grantbreaksthings/buggyboy/docs/dtmf_r.png

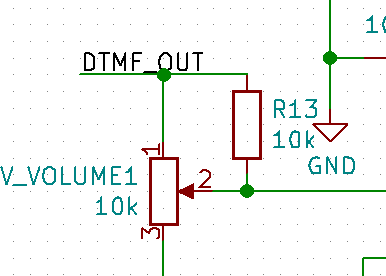
docs/dtmf_r.png
