grantbreaksthings/buggyboy/docs/mic_r.png

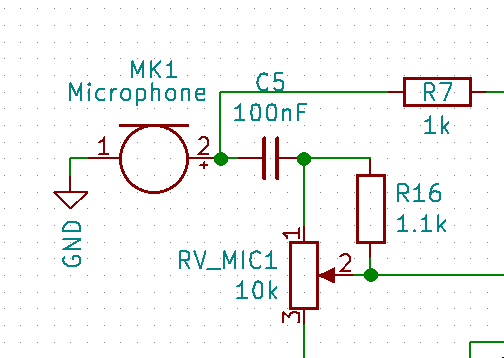
docs/mic_r.png
