grantbreaksthings/buggyboy/hardware/buggyboy/brains.kicad_pcb

## KiCad design hardware/buggyboy/brains.kicad_pcb (2022-06-12)

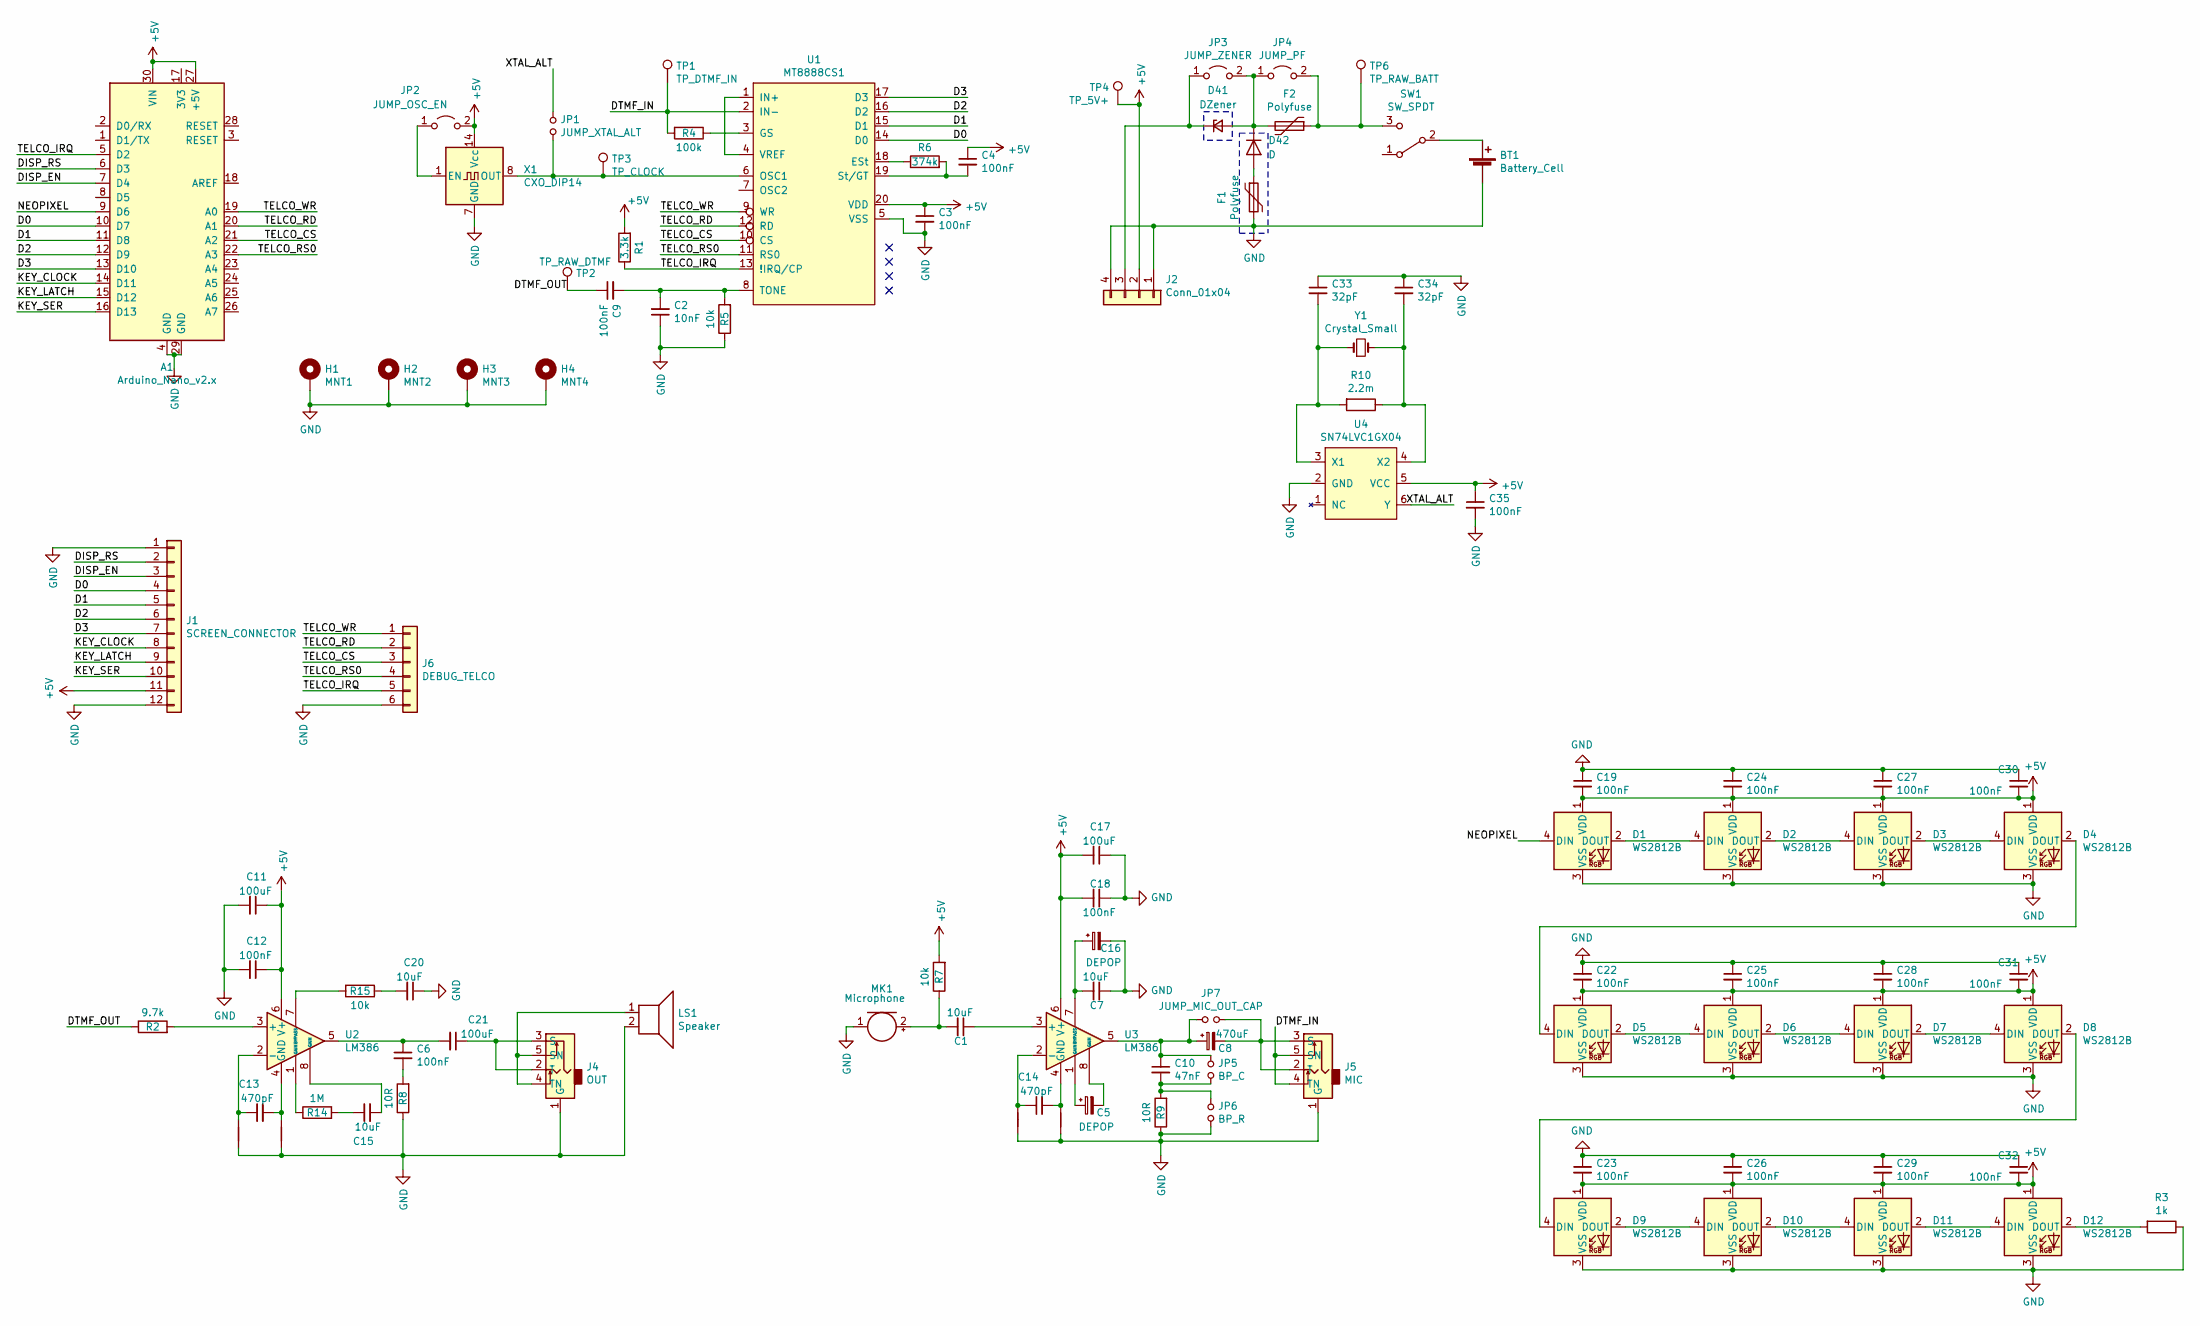
[picture p3: schematic brains.sch]

Parts:
A1: Arduino_Nano_v2.x; Arduino_Nano
BT1: Battery_Cell; BatteryHolder_BC2AAPC
C1, C7, C15, C20: 10uF; C_0805_2012Metric_Pad1.18x1.45mm_HandSolder
C2: 10nF; C_0805_2012Metric_Pad1.18x1.45mm_HandSolder
C3, C4, C6, C9, C12, C18, C19, C22, C23, C24, C25, C26, C27, C28, C29, C30, C31, C32, C35: 100nF; C_0603_1608Metric_Pad1.08x0.95mm_HandSolder
C5, C16: DEPOP; CP_Radial_D8.0mm_P3.80mm
C8: 470uF; CP_Radial_D8.0mm_P3.80mm
C10: 47nF; C_0603_1608Metric_Pad1.08x0.95mm_HandSolder
C11, C17, C21: 100uF; C_1206_3216Metric_Pad1.33x1.80mm_HandSolder
C13, C14: 470pF; C_0805_2012Metric_Pad1.18x1.45mm_HandSolder
C33, C34: 32pF; C_0402_1005Metric_Pad0.74x0.62mm_HandSolder
D1, D2, D3, D4, D5, D6, D7, D8, D9, D10, D11, D12: WS2812B; LED_WS2812B_PLCC4_5.0x5.0mm_P3.2mm
D41: DZener; D_SMB_Handsoldering
D42: D; D_SMA_Handsoldering
F1, F2: Polyfuse; Fuse_Littelfuse_395Series
H1: MNT1; MountingHole_4.3mm_M4_Pad_Via
H2: MNT2; MountingHole_4.3mm_M4_Pad_Via
H3: MNT3; MountingHole_4.3mm_M4_Pad_Via
H4: MNT4; MountingHole_4.3mm_M4_Pad_Via
J1: SCREEN_CONNECTOR; PinHeader_1x12_P2.54mm_Vertical
J2: Conn_01x04; MT3608_MODULE
J4: OUT; CUI_SJ1-3545N
J5: MIC; CUI_SJ1-3545N
J6: DEBUG_TELCO; PinHeader_1x06_P2.54mm_Vertical
JP1: JUMP_XTAL_ALT; SolderJumper-2_P1.3mm_Open_RoundedPad1.0x1.5mm
JP2: JUMP_OSC_EN; SolderJumper-2_P1.3mm_Open_RoundedPad1.0x1.5mm
JP3: JUMP_ZENER; SolderJumper-2_P1.3mm_Open_RoundedPad1.0x1.5mm
JP4: JUMP_PF; SolderJumper-2_P1.3mm_Open_RoundedPad1.0x1.5mm
JP5: BP_C; SolderJumper-2_P1.3mm_Open_RoundedPad1.0x1.5mm
JP6: BP_R; SolderJumper-2_P1.3mm_Open_RoundedPad1.0x1.5mm
JP7: JUMP_MIC_OUT_CAP; SolderJumper-2_P1.3mm_Open_RoundedPad1.0x1.5mm
LS1: Speaker; PinSocket_1x02_P2.54mm_Vertical
MK1: Microphone; PinSocket_1x02_P2.54mm_Vertical
NT1, NT2, NT3, NT4: Net-Tie_2; NetTie-2_SMD_Pad0.5mm
R1: 3.3k; R_0805_2012Metric_Pad1.20x1.40mm_HandSolder
R2: 9.7k; R_0805_2012Metric_Pad1.20x1.40mm_HandSolder
R3: 1k; R_0805_2012Metric_Pad1.20x1.40mm_HandSolder
R4: 100k; R_0805_2012Metric_Pad1.20x1.40mm_HandSolder
R5, R7, R15: 10k; R_0805_2012Metric_Pad1.20x1.40mm_HandSolder
R6: 374k; R_0805_2012Metric_Pad1.20x1.40mm_HandSolder
R8, R9: 10R; R_0805_2012Metric_Pad1.20x1.40mm_HandSolder
R10: 2.2m; R_0805_2012Metric_Pad1.20x1.40mm_HandSolder
R14: 1M; R_0805_2012Metric_Pad1.20x1.40mm_HandSolder
SW1: SW_SPDT; SW_E-Switch_EG1224_SPDT_Angled
TP1: TP_DTMF_IN; TestPoint_Pad_D2.5mm
TP2: TP_RAW_DTMF; TestPoint_Pad_D2.5mm
TP3: TP_CLOCK; TestPoint_Pad_D2.5mm
TP4: TP_5V+; TestPoint_Pad_D2.5mm
TP6: TP_RAW_BATT; TestPoint_Pad_D2.5mm
U1: MT8888CS1; SOIC-20W_7.5x12.8mm_P1.27mm
U2, U3: LM386; DIP-8_W7.62mm_LongPads
U4: SN74LVC1GX04; SOT-563
X1: CXO_DIP14; Oscillator_DIP-14
Y1: Crystal_Small; Crystal_HC49-U_Vertical

Connections:
+5V: A1.27 (+5V), A1.30 (VIN), C3.1, C4.1, C11.1, C12.1, C17.2, C18.2, C19.2, C22.2, C23.2, C24.2, C25.2, C26.2, C27.2, C28.2, C29.2, C30.2, C31.2, C32.2, C35.1, D1.1 (VDD), D2.1 (VDD), D3.1 (VDD), D4.1 (VDD), D5.1 (VDD), D6.1 (VDD), D7.1 (VDD), D8.1 (VDD), D9.1 (VDD), D10.1 (VDD), D11.1 (VDD), D12.1 (VDD), J1.11, J2.2, JP2.2 (B), R1.2, R7.2, TP4.1, U1.20 (VDD), U2.6 (V+), U3.6 (V+), U4.5 (VCC), X1.14 (Vcc)
/D0: A1.10 (D7), J1.4, U1.14 (D0)
/D1: A1.11 (D8), J1.5, U1.15 (D1)
/D2: A1.12 (D9), J1.6, U1.16 (D2)
/D3: A1.13 (D10), J1.7, U1.17 (D3)
/DISP_EN: A1.7 (D4), J1.3
/DISP_RS: A1.6 (D3), J1.2
/DTMF_IN: J5.4 (TN), J5.5 (SN), R4.2, TP1.1, U1.2 (IN-)
/DTMF_OUT: C9.1, R2.1, TP2.1
/KEY_CLOCK: A1.14 (D11), J1.8
/KEY_LATCH: A1.15 (D12), J1.9
/KEY_SER: A1.16 (D13), J1.10
/NEOPIXEL: A1.9 (D6), D1.4 (DIN)
/TELCO_CS: A1.21 (A2), J6.3, U1.10 (CS)
/TELCO_IRQ: A1.5 (D2), J6.5, R1.1, U1.13 (!IRQ/CP)
/TELCO_RD: A1.20 (A1), J6.2, U1.12 (RD)
/TELCO_RS0: A1.22 (A3), J6.4, U1.11 (RS0)
/TELCO_WR: A1.19 (A0), J6.1, U1.9 (WR)
/XTAL_ALT: JP1.1, U4.6 (Y)
GND: A1.4 (GND), A1.29 (GND), BT1.2 (-), C2.1, C3.2, C7.1, C11.2, C12.2, C16.2, C17.1, C18.1, C19.1, C20.1, C22.1, C23.1, C24.1, C25.1, C26.1, C27.1, C28.1, C29.1, C30.1, C31.1, C32.1, C33.1, C34.1, C35.2, D1.3 (VSS), D2.3 (VSS), D3.3 (VSS), D4.3 (VSS), D5.3 (VSS), D6.3 (VSS), D7.3 (VSS), D8.3 (VSS), D9.3 (VSS), D10.3 (VSS), D11.3 (VSS), D12.3 (VSS), F1.2, H1.1, H2.1, H3.1, H4.1, J1.1, J1.12, J2.1, J2.4, J4.1 (G), J5.1 (G), J6.6, JP6.2, LS1.2, MK1.1 (-), NT1.2, NT2.2, NT3.2, NT4.2, R3.1, R5.1, R8.1, R9.1, U1.5 (VSS), U4.2 (GND), X1.7 (GND)
unnamed: BT1.1 (+), SW1.2 (B)
unnamed: C1.1, U3.3 (+)
unnamed: C1.2, MK1.2 (+), R7.1
unnamed: C2.2, C9.2, R5.2, U1.8 (TONE)
unnamed: C4.2, R6.2, U1.19 (St/GT)
unnamed: C5.1, U3.1 (GAIN)
unnamed: C5.2, U3.8 (GAIN)
unnamed: C6.2, R8.2
unnamed: C8.2, J5.2 (T), J5.3 (S), JP7.2
unnamed: C8.1, C10.1, JP5.1, JP7.1, U3.5
unnamed: C10.2, JP5.2, JP6.1, R9.2
unnamed: C13.1, NT1.1, U2.2 (-)
unnamed: C13.2, NT2.1, U2.4 (GND)
unnamed: C14.1, NT3.1, U3.2 (-)
unnamed: C14.2, NT4.1, U3.4 (GND)
unnamed: C15.1, R14.2
unnamed: C15.2, U2.8 (GAIN)
unnamed: C7.2, C16.1, U3.7 (BYPASS)
unnamed: C20.2, R15.1
unnamed: C21.1, J4.2 (T), J4.3 (S)
unnamed: C6.1, C21.2, U2.5
unnamed: C33.2, R10.2, U4.3 (X1), Y1.1
unnamed: C34.2, R10.1, U4.4 (X2), Y1.2
unnamed: D1.2 (DOUT), D2.4 (DIN)
unnamed: D2.2 (DOUT), D3.4 (DIN)
unnamed: D3.2 (DOUT), D4.4 (DIN)
unnamed: D4.2 (DOUT), D5.4 (DIN)
unnamed: D5.2 (DOUT), D6.4 (DIN)
unnamed: D6.2 (DOUT), D7.4 (DIN)
unnamed: D7.2 (DOUT), D8.4 (DIN)
unnamed: D8.2 (DOUT), D9.4 (DIN)
unnamed: D10.2 (DOUT), D11.4 (DIN)
unnamed: D9.2 (DOUT), D10.4 (DIN)
unnamed: D11.2 (DOUT), D12.4 (DIN)
unnamed: D12.2 (DOUT), R3.2
unnamed: D41.1 (K), J2.3, JP3.1 (A)
unnamed: D41.2 (A), D42.1 (K), F2.2, JP3.2 (B), JP4.1 (A)
unnamed: D42.2 (A), F1.1
unnamed: F2.1, JP4.2 (B), SW1.3 (C), TP6.1
unnamed: J4.4 (TN), J4.5 (SN), LS1.1
unnamed: JP1.2, TP3.1, U1.6 (OSC1), X1.8 (OUT)
unnamed: JP2.1 (A), X1.1 (EN)
unnamed: R2.2, U2.3 (+)
unnamed: R4.1, U1.3 (GS)
unnamed: R6.1, U1.18 (ESt)
unnamed: R14.1, U2.1 (GAIN)
unnamed: R15.2, U2.7 (BYPASS)
unnamed: U1.1 (IN+), U1.4 (VREF)

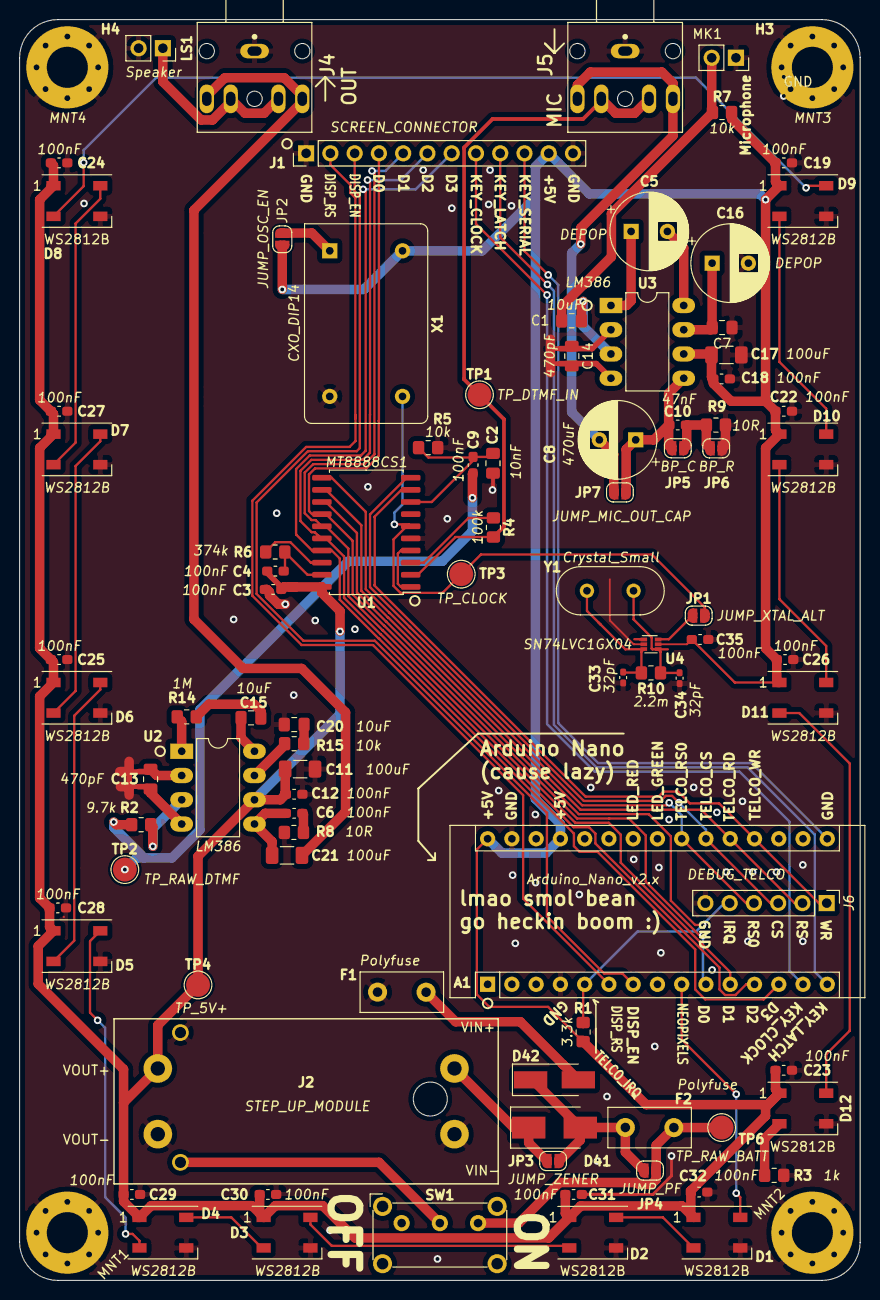
[picture p4: board brains.kicad_pcb from above]

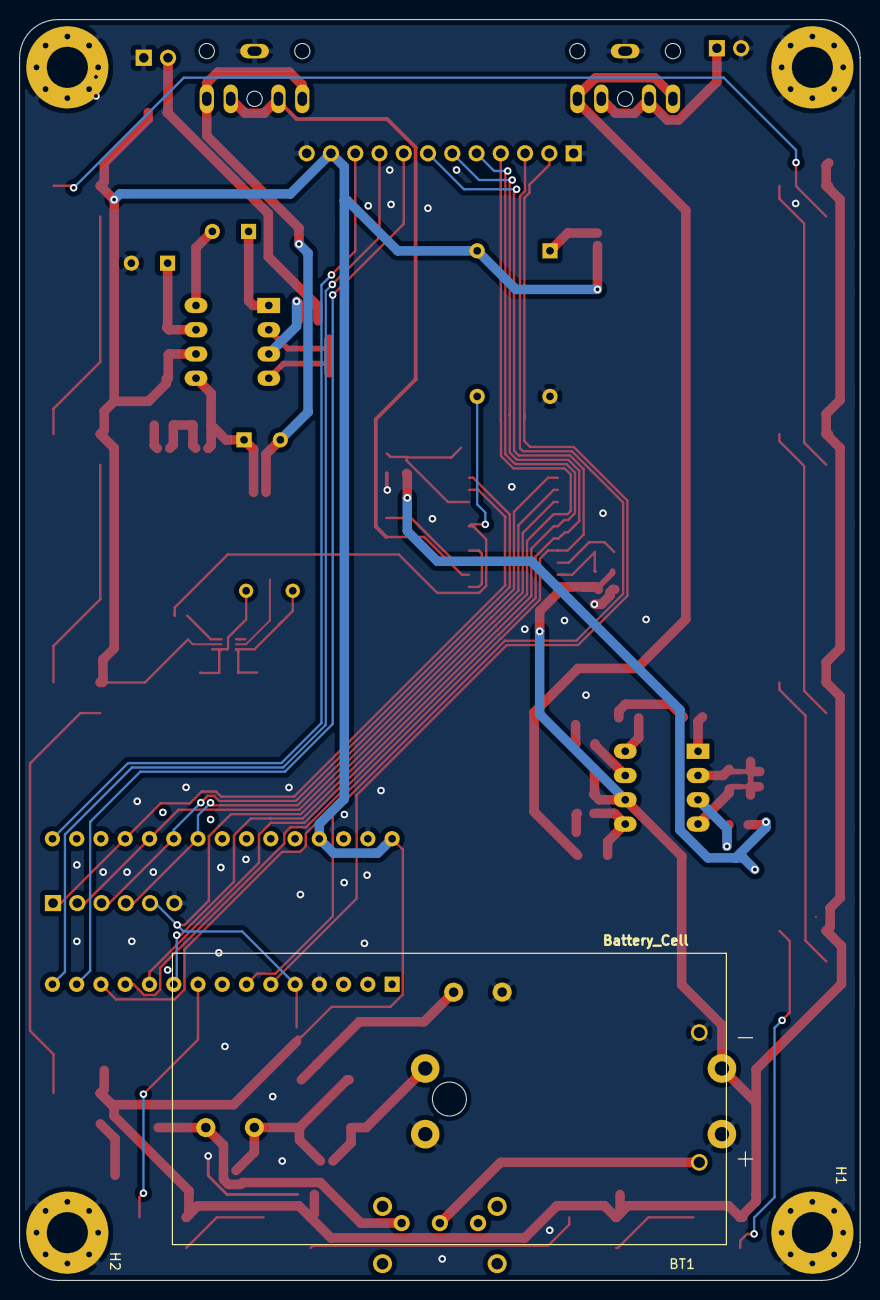
[picture p5: board brains.kicad_pcb from below]

Board: 2 copper layers, 88.0 x 132.0 mm, 99 parts (3 on the bottom side), 68 nets.
