grantbreaksthings/buggyboy/hardware/buggyboy/keypad.kicad_pcb

## KiCad design hardware/buggyboy/keypad.kicad_pcb (2022-06-12)

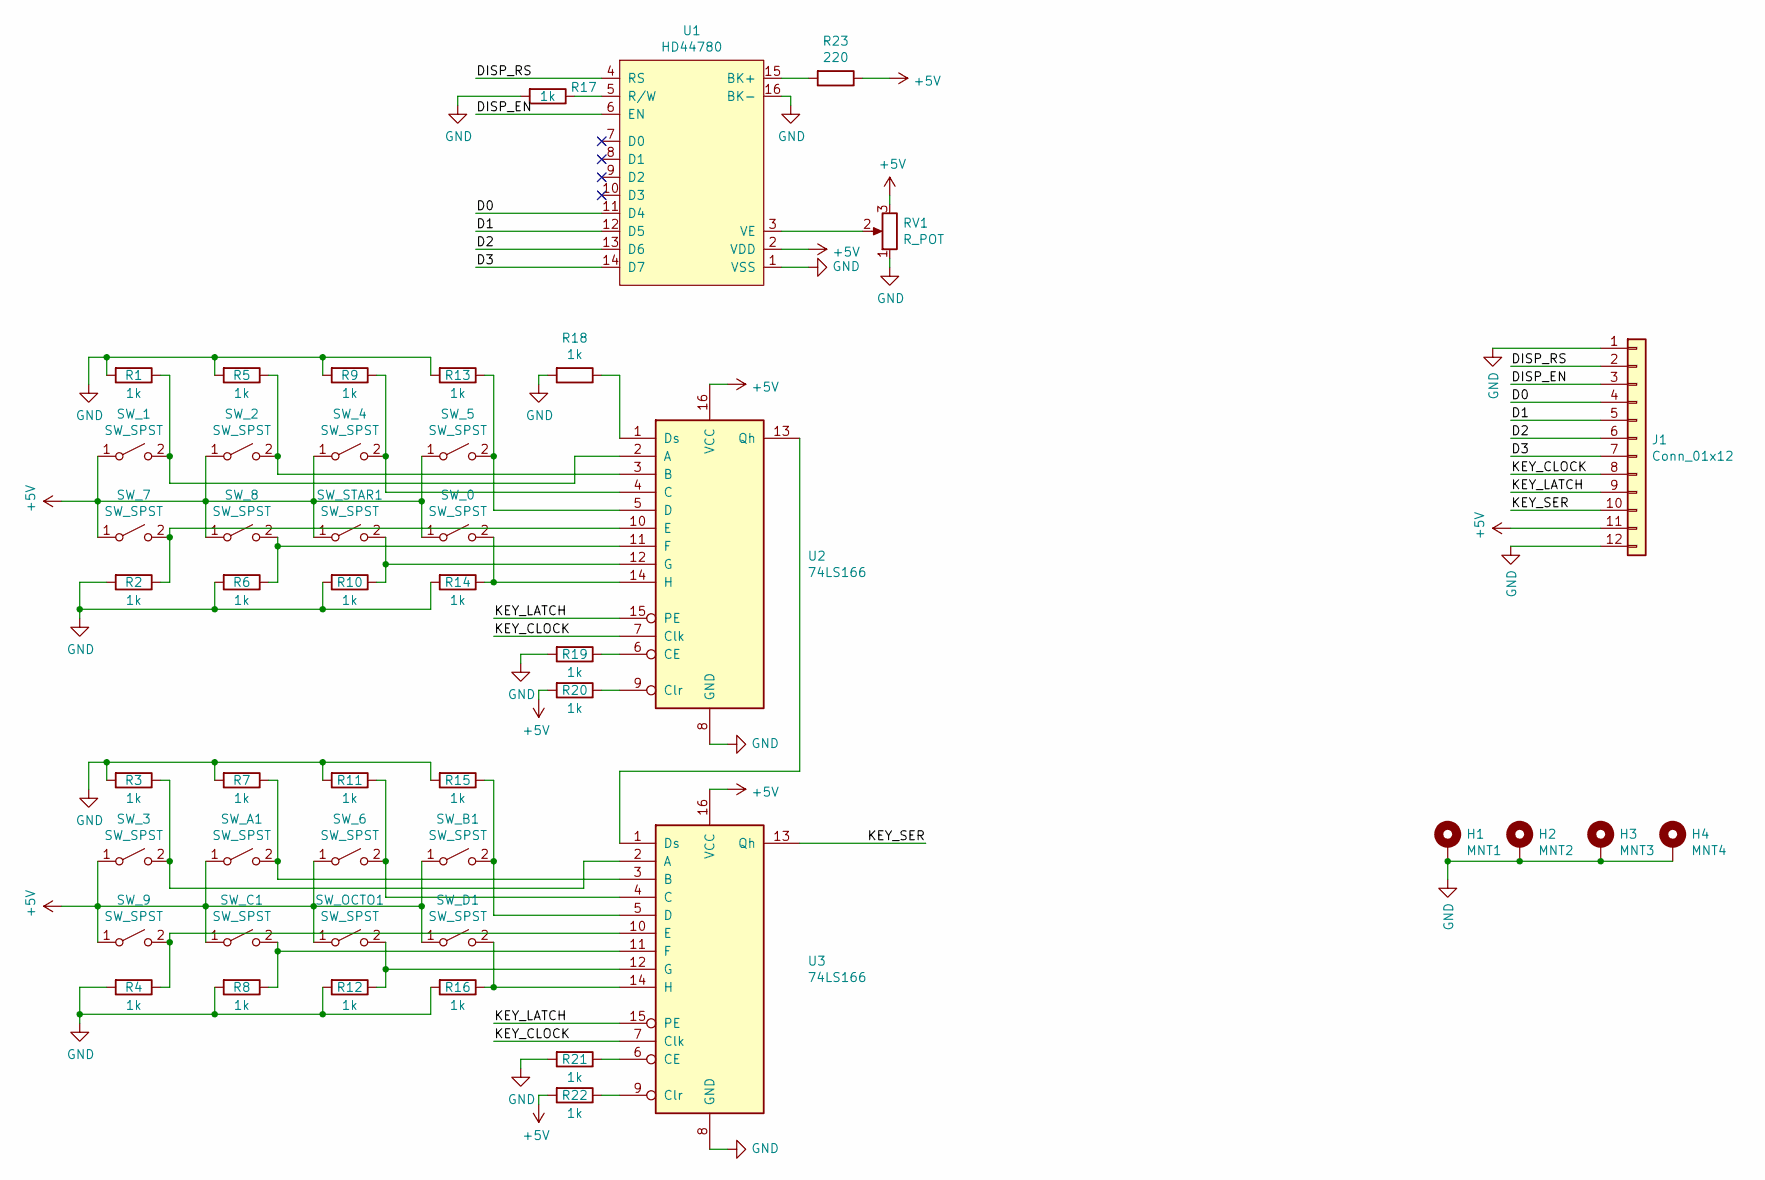
[picture p6: schematic keypad.sch]

Parts:
H1: MNT1; MountingHole_4.3mm_M4_Pad_Via
H2: MNT2; MountingHole_4.3mm_M4_Pad_Via
H3: MNT3; MountingHole_4.3mm_M4_Pad_Via
H4: MNT4; MountingHole_4.3mm_M4_Pad_Via
J1: Conn_01x12; PinHeader_1x12_P2.54mm_Vertical
R1, R2, R3, R4, R5, R6, R7, R8, R9, R10, R11, R12, R13, R14, R15, R16, R17, R18, R19, R20, R21, R22: 1k; R_0603_1608Metric_Pad0.98x0.95mm_HandSolder
R23: 220; R_0603_1608Metric_Pad0.98x0.95mm_HandSolder
RV1: R_POT; TRIM_3313J-1-103E
SW_0, SW_1, SW_2, SW_3, SW_4, SW_5, SW_6, SW_7, SW_8, SW_9: SW_SPST; SW_Cherry_MX_1.00u_PCB
SW_A1: SW_SPST; SW_Cherry_MX_1.00u_PCB
SW_B1: SW_SPST; SW_Cherry_MX_1.00u_PCB
SW_C1: SW_SPST; SW_Cherry_MX_1.00u_PCB
SW_D1: SW_SPST; SW_Cherry_MX_1.00u_PCB
SW_OCTO1: SW_SPST; SW_Cherry_MX_1.00u_PCB
SW_STAR1: SW_SPST; SW_Cherry_MX_1.00u_PCB
U1: HD44780; WC1602A
U2, U3: 74LS166; DIP-16_W7.62mm_LongPads

Connections:
+5V: J1.11, R20.2, R22.2, R23.1, RV1.3, SW_0.1 (A), SW_1.1 (A), SW_2.1 (A), SW_3.1 (A), SW_4.1 (A), SW_5.1 (A), SW_6.1 (A), SW_7.1 (A), SW_8.1 (A), SW_9.1 (A), SW_A1.1 (A), SW_B1.1 (A), SW_C1.1 (A), SW_D1.1 (A), SW_OCTO1.1 (A), SW_STAR1.1 (A), U1.2 (VDD), U2.16 (VCC), U3.16 (VCC)
/D0: J1.4, U1.11 (D4)
/D1: J1.5, U1.12 (D5)
/D2: J1.6, U1.13 (D6)
/D3: J1.7, U1.14 (D7)
/DISP_EN: J1.3, U1.6 (EN)
/DISP_RS: J1.2, U1.4 (RS)
/KEY_CLOCK: J1.8, U2.7 (Clk), U3.7 (Clk)
/KEY_LATCH: J1.9, U2.15 (PE), U3.15 (PE)
/KEY_SER: J1.10, U3.13 (Qh)
GND: H1.1, H2.1, H3.1, H4.1, J1.1, J1.12, R1.2, R2.2, R3.2, R4.2, R5.2, R6.2, R7.2, R8.2, R9.2, R10.2, R11.2, R12.2, R13.2, R14.2, R15.2, R16.2, R17.2, R18.2, R19.2, R21.2, RV1.1, U1.1 (VSS), U1.16 (BK-), U2.8 (GND), U3.8 (GND)
unnamed: R1.1, SW_1.2 (B), U2.2 (A)
unnamed: R2.1, SW_7.2 (B), U2.10 (E)
unnamed: R3.1, SW_3.2 (B), U3.2 (A)
unnamed: R4.1, SW_9.2 (B), U3.10 (E)
unnamed: R5.1, SW_2.2 (B), U2.3 (B)
unnamed: R6.1, SW_8.2 (B), U2.11 (F)
unnamed: R7.1, SW_A1.2 (B), U3.3 (B)
unnamed: R8.1, SW_C1.2 (B), U3.11 (F)
unnamed: R9.1, SW_4.2 (B), U2.4 (C)
unnamed: R10.1, SW_STAR1.2 (B), U2.12 (G)
unnamed: R11.1, SW_6.2 (B), U3.4 (C)
unnamed: R12.1, SW_OCTO1.2 (B), U3.12 (G)
unnamed: R13.1, SW_5.2 (B), U2.5 (D)
unnamed: R14.1, SW_0.2 (B), U2.14 (H)
unnamed: R15.1, SW_B1.2 (B), U3.5 (D)
unnamed: R16.1, SW_D1.2 (B), U3.14 (H)
unnamed: R17.1, U1.5 (R/W)
unnamed: R18.1, U2.1 (Ds)
unnamed: R19.1, U2.6 (CE)
unnamed: R20.1, U2.9 (Clr)
unnamed: R21.1, U3.6 (CE)
unnamed: R22.1, U3.9 (Clr)
unnamed: R23.2, U1.15 (BK+)
unnamed: RV1.2, U1.3 (VE)
unnamed: U2.13 (Qh), U3.1 (Ds)

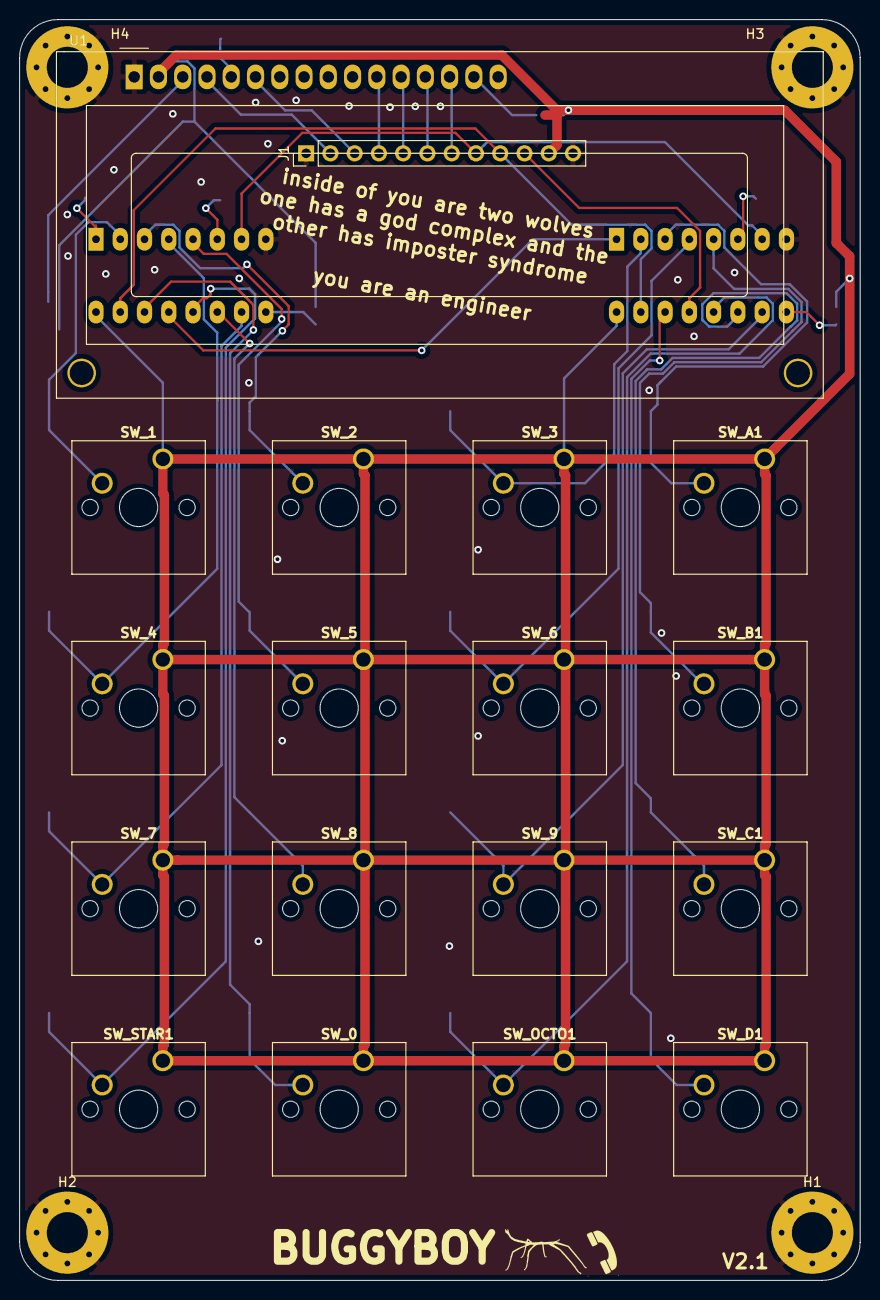
[picture p7: board keypad.kicad_pcb from above]

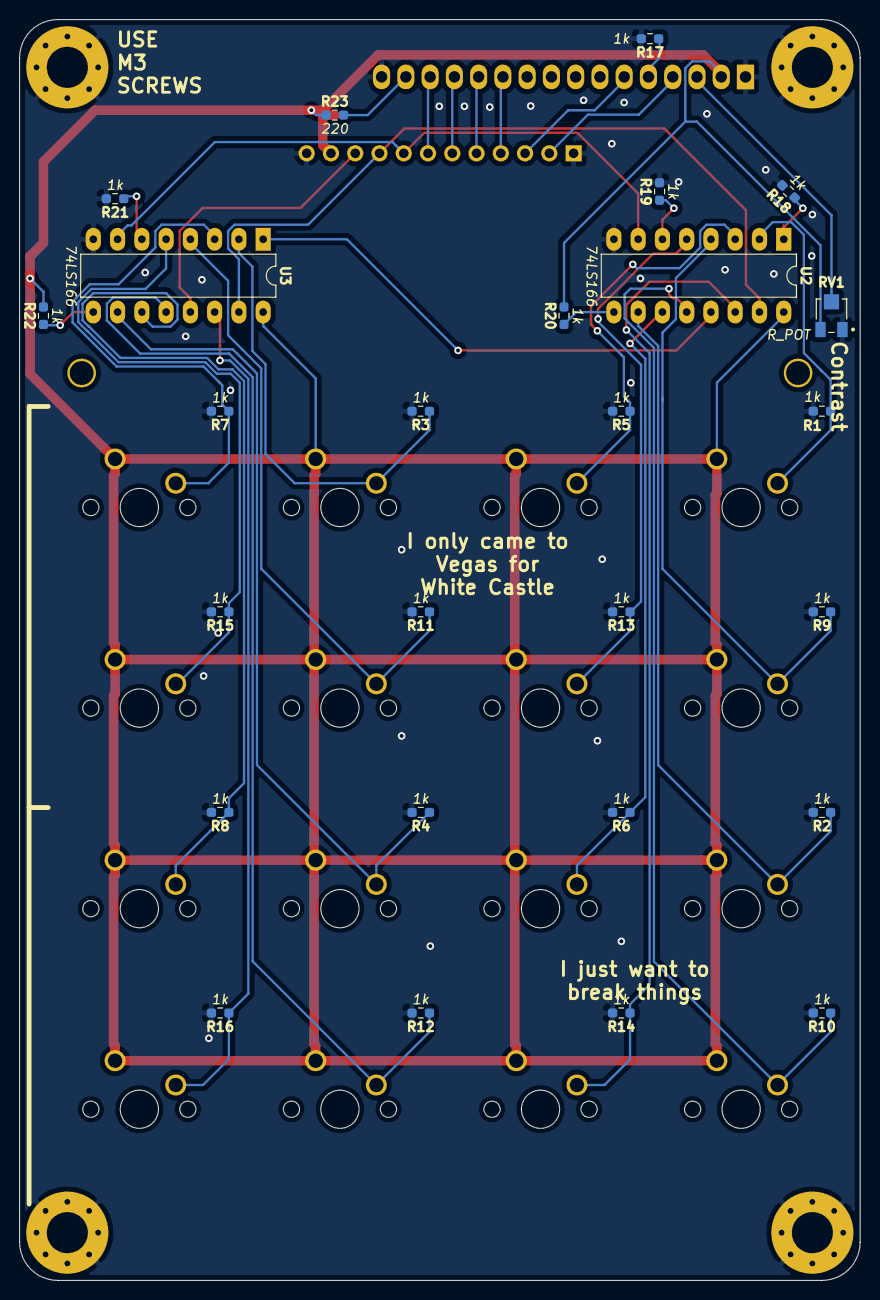
[picture p8: board keypad.kicad_pcb from below]

Board: 2 copper layers, 88.0 x 132.0 mm, 48 parts (26 on the bottom side), 36 nets.
