grantbreaksthings/buggyboy/(commit log)

2022-05-31 before redoin
    [brains.sch]
2022-05-31 routed again
    [brains.kicad_pcb, brains.sch]
